John-Nagle/ttyloopdriver/case/README.md

# Ttyloopdriver case
Case for the device

## Parts

- Hammond Manufacturing 1455J1201BK. Mouser Part #: 546-1455J1201BK

- 1/8" black acrylic or acetyl sheet suitable for laser cutting

- 6-32 screws, 1/2", steel, hex or pan head, 8ea.

## End panel cutouts

The CorelDraw file is for laser cutting the end panels from plastic
sheet. CorelDraw is used because TechShop's laser cutters use it.
The file is also available as .png and .svg.
