John-Nagle/ttyloopdriver/board/images/boardpopulatedv1.0.jpg

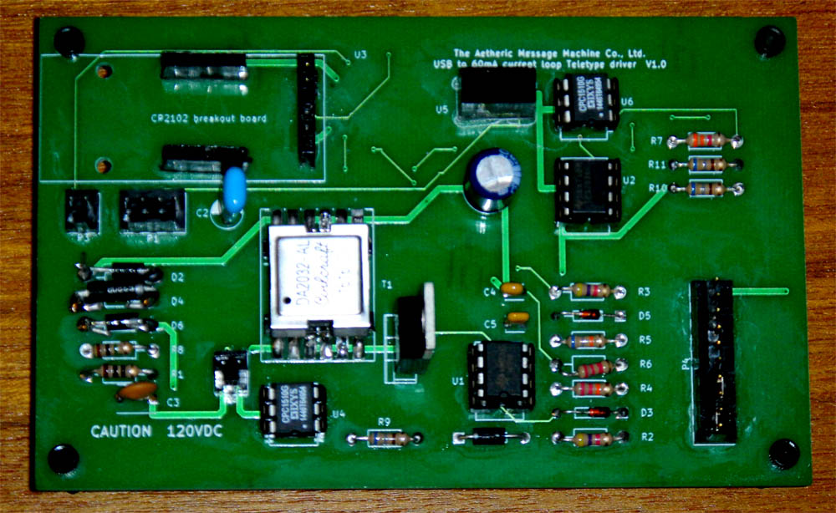
board/images/boardpopulatedv1.0.jpg
