John-Nagle/ttyloopdriver/board/images/schematic.png

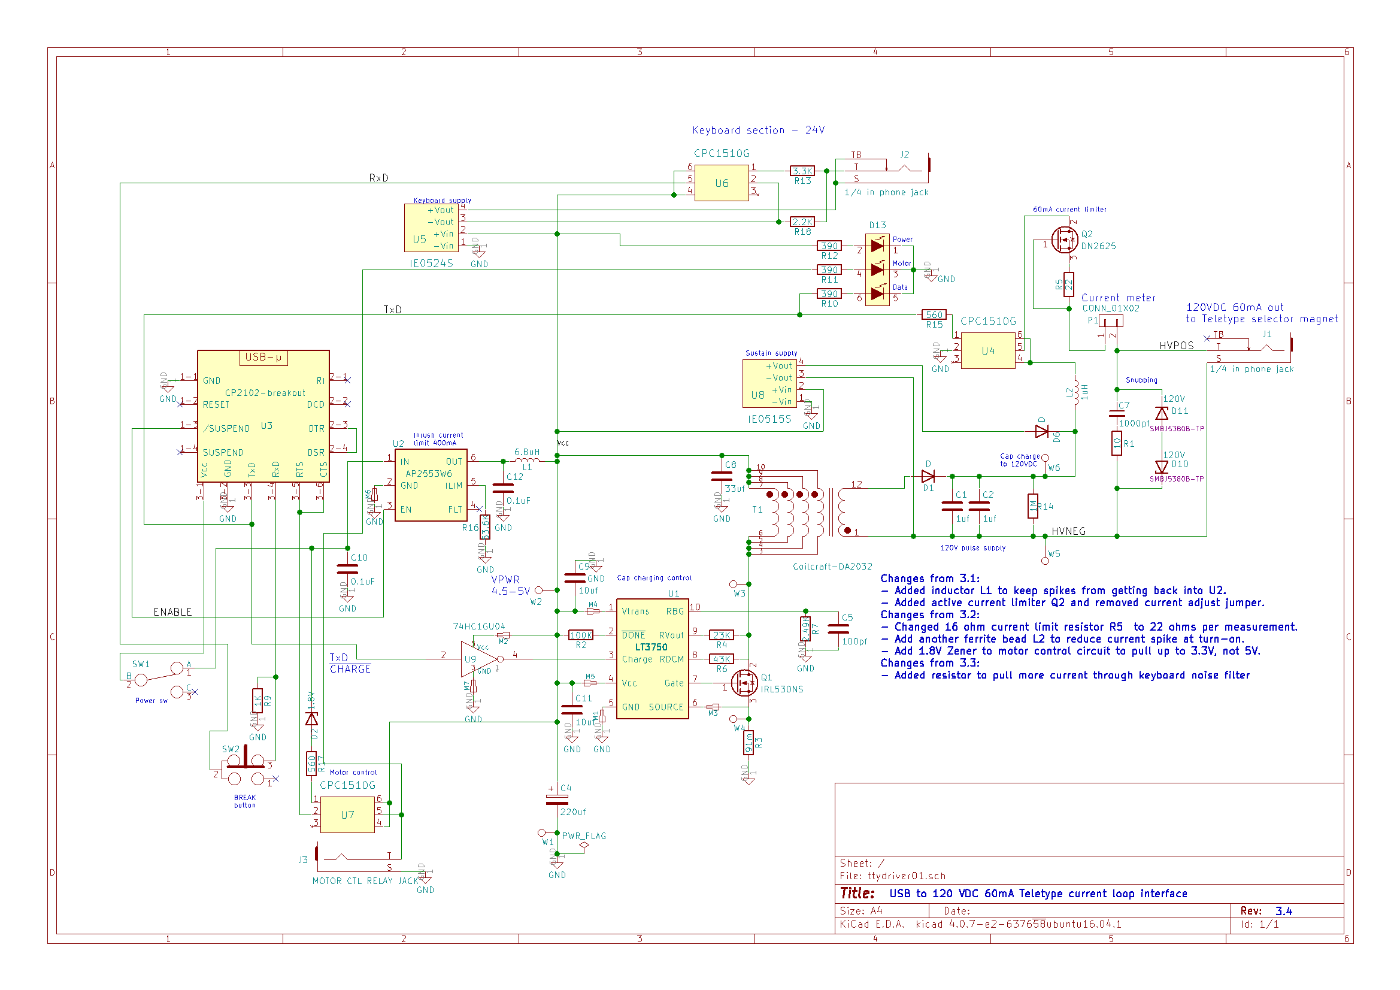
board/images/schematic.png
