John-Nagle/ttyloopdriver/parts/auxparts.ods

Auxiliary parts not in schematic BOMs
Description | Mfgr | Part | Vendor | Vendorpart | Quan | Datasheet
Enclosure | Hammond | 1455K1202 | Digikey | HM973-ND | 1 | http://www.hammondmfg.com/pdf/1455K1202.pdf
DIP socket 8 pin | Assman | A 08-LC-TT | Digikey | AE9986-ND | 2
DIP socket 6 pin | Assman | A 06-LC-TT | Digikey | AE1485-ND | 2
Silver solder | MG Chem | 4900-35G | Digikey | 473-1116-ND | 1
Desoldering tool | Aven | 17537 | Digikey | 243-1184-ND | 1 | http://media.digikey.com/pdf/Data%20Sheets/Aven%20PDFs/17537.pdf
Capacitor 1uf ceramic | Murata | RDER72E105MUB1H03B | Digikey | 490-8911-ND | 0 | http://www.murata.com/~/media/webrenewal/support/library/catalog/products/capacitor/mlcc/c49e.ashx
LED red | Broadcom | HLMP-3301-F00DD | Digikey | 516-3178-3-ND | 1 | http://www.avagotech.com/docs/AV02-1558EN
LED green | Broadcom | HLMP-3519-F0002 | Digikey | 516-3137-2-ND | 1 | http://www.avagotech.com/docs/AV02-1558EN
