John-Nagle/ttyloopdriver/(threads)

Thread 1 (2016-11-15):

Flaws in v1.0 board layout

John-Nagle, 2016-11-15:
- Q1 is backwards. This is from an error in the custom footprint. The leads are named Gate, Source, and Drain on the data sheet, rather than having pin numbers.

- Holes for D2, D4, and D6 are too small for the component leads.

- Holes for the mounting screws of U3 are too small.

- Lead spacing for C2 is too small since C2 was changed from an electrolytic to a ceramic.

John-Nagle, 2016-12-20:
Complete redesign underway

John-Nagle, 2017-04-12:
Fixed in 2.0

Closed 2017-04-12.

Thread 2 (2016-11-15):

Oscillator frequency is off

John-Nagle, 2016-11-15:
The as-built oscillator for the switcher is running at 80KHz, instead of the designed 100KHz. Also, the duty cycle seems to be higher than the designed 25%.

John-Nagle, 2016-12-20:
Complete redesign underway.

John-Nagle, 2017-04-12:
On 2.0 board, now at 85KHz, 50% duty cycle. Switcher seems to work OK, though.

John-Nagle, 2017-10-26:
Fixed in 3.x boards, which eliminate the 555 timer and use a LT3750. Switcher frequency now around 300KHz.

Closed 2017-10-26.

Thread 3 (2017-04-12):

Flaws in V2.0 board layout.

John-Nagle, 2017-04-12:
Needed changes:

- Change all test points to use header-type pins [DONE]

- R16 was ordered as 53.6 ohms, not Kohms. [DONE]

- Move R16 closer to U2. [DONE]

- Need to invert motor-on signal - RTS is a pulldown. [DONE]

- D12 causing too much voltage drop for sustain - redesign LED drive [DONE]

- TxD, RxD, RTS are 3.3V, not 5V; adjust resistor values R15. [DONE]

- Add RTS resistor [DONE]

- C2 - Use 1uF leaded ceramic.  The new multilayer SMT ceramics have very strange properties; the capacitance decreases as the voltage increases. Avoid until technology improves.

- Output side of U6 may be wired backwards. [DONE]

- Need pulldown on RxD. [DONE]

John-Nagle, 2017-04-12:
Fixed in 2.1.

Closed 2017-04-12.

Thread 4 (2017-04-27):

1uf doesn't provide enough energy to pull in the selector magnet

John-Nagle, 2017-04-27:
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

Here's a scope trace of voltage and current going into the selector magnet.  Voltage is inverted.

V is going up to about 110V.  So the cap is being fully charged.  The cap discharges in 2.5ms, and then
the sustain supply takes over.

I ramps up to about 50mA in 1ms, which is fine. But then it drops all the way down to 25mA as the cap discharges into the magnet, then goes back up as the sustain supply takes over. So 1uF isn't enough to fully charge the selector magnet. The board is functioning as intended, but just doesn't deliver enough current for long enough. The board will run one Model 15 with the selector wired for 220 ohms, but won't pull in the magnet fast enough on two different Model 14 machines, one wired for 220 ohms and the other wired for 55 ohms.

What is the actual inductance of a Teletype model 14/15 selector magnet, and what's the source for
that?  This works in SPICE assuming a 55 ohm 4H selector magnet.  I just tried a simulation with a 220 ohm 16H selector magnet, and that doesn't show the drop in current seen here.

John-Nagle, 2017-10-26:
Fixed in 3.x boards, which have 2uf and a different charging system.

Closed 2017-10-26.

Thread 5 (2018-03-09):

Keyboard input does not work with Teletype Model 15 with 92222 Filter

John-Nagle, 2018-03-09:
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

Keyboard input drops bits when the keyboard used is a Teletype Model 15 with the 92222 Filter. This is an RF noise filter present on some Teletype machines. The board design provides 24VDC for the keyboard but only draws 5mA  through the keyboard contacts. That may not be enough with the filter's added capacitance. The board may need a resistor to add some extra load.

John-Nagle, 2018-03-09:
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
This is the filter unit. It's attached above the keyboard contact cam unit.

Thread 6 (2018-06-21):

Motor Control logic is inverted from what is described

cclaunch, 2018-06-21:
The Motor Control solid state relay activates when RTS/CTS goes to low, triggering the Motor LED and sending 5V out the jack. This is the opposite of what is intended, to have the motor switch on when RTS/CTS goes high.

Closed 2018-06-26.

Thread 7 (2018-06-21):

Documentation flaw

cclaunch, 2018-06-21:
In addition to the inverted behavior of Motor control, the documentation states that the top LED indicates Power (in the section POWER MANAGEMENT) then correctly states that it is the bottom LED in the INITIAL TESTING section.

John-Nagle, 2018-07-02:
Good point on LEDs

John-Nagle, 2018-07-02:
README.md file fixed.

Closed 2018-07-02.

Thread 9 (2022-02-12):

Substitute for Q2 Needed (Impossible to buy)

va3ngc, 2022-02-12:
Is there a suitable substitute for Q2 (DN2625K4-G) as these seem to be backordered for at least a year at Digi-Key and Mouser and there are none available currently on eBay either?

va3ngc, 2022-12-01:
Was able to find Q2 from UK via Newark.  Issue has been resolved.

John-Nagle, 2022-12-07:
I'm glad you found one.

Q2 is for a two-component current regulator with significant power dissipation capability. It limits the output loop current to 60mA, even for a dead short. Unfortunately, depletion-mode FETs are somewhat exotic parts, because few people do current loops today.

Closed 2022-12-01.
