John-Nagle/ttyloopdriver/circuitsim/capcharger.asc

A1: inv; Vhigh=3.3
C1: cap; 1µf; Rser=0.1
C2: cap; 1µf; Rser=0.1
C4: cap; 220µf
C5: cap; 100p
C6: cap; 0.1µf; Rser=0.1
C7: cap; 1000pf
C8: cap; 33µf; Rser=0.1
D1: diode
D6: diode; MURS120
D10: zener; 1N5380BG
D11: zener; 1N5380BG
L1: ind; 6.8µ; Ipk=1A Rser=0.312 Cpar=0
L2: ind; 1µ; Ipk=2.3A Rser=0.090 Cpar=0
L3: ind2; 10µ; Cpar=200p
L4: ind2; 1m
L5: ind; 5.5H; Rser=220
M1: nmos; DN2535
Q1: nmos; IRL530NS_L
R1: res; 10
R2: res; 100K
R3: res; 91m
R4: res; 23K
R5: res; 22
R6: res; 43K
R7: res; 2.49K
S1: sw; SW1
U1: LT3750
V1: voltage; 4.8; Rser=0.1
V2: voltage; 15V; Rser=1
V3: voltage; PULSE(0 3.3 0 1us 1us 22ms 44ms)
Named nets: 0, Vcap, Vsel, Charge, ser, Vcc
.tran 0 100ms 0
ESR 0.1 ohm
.model 1N5380BG D(bv=120v ibv=1ma mfg=OnSemi type=Zener)
.model SW1 SW(Ron=1.7 Roff=10Meg Vt=1.1 Vh=0.1)
Selector magnet
Sustain supply
(XP Power IE0515S)
Serial data source
CPC1510G opto
Snubbing
K1 L3 L4 1
Notes:
- Based on Linear Technology sample circuit for LT3750.
- Recommended transformer and MOSFET per LT example.
- Input current limit is set with R3. I = 78mV/R2
- Max voltage of charge is set with R4.
- Charges 2uf cap to 120V.
- Should provide 60mA into 5.5H selector
Teletype loop driver using LT3750  Capacitor Charger Controller
Input: 4.8V   Output: 120V
Coilcraft DA2032-AL
.lib dn2535.lib
60mA current limiter
Model for M1 should be DN2625, not DN2535. They're close but not identical.
