John-Nagle/ttyloopdriver/circuitsim/ttydriver.asc

C1: cap; 22µf; Rser=0.1
C2: cap; 1µf; Rser=0.1
C3: cap; 10pf
C4: cap; 1000pf; Rser=0.1
C5: cap; 22µf; Rser=0.1
C6: cap; 10nf
C7: cap; 1000pf
C8: cap; 910pf
C9: polcap; 470µf; Rser=2
C11: cap; 1µf; Rser=0.1
C13: cap; 22µf; Rser=0.1
C14: polcap; 470µf; Rser=2
D1: diode; MURS120
D6: diode; MURS120
D7: zener; 1N5380BG
D9: schottky; RSX071VA-30
D10: zener; 1N5380BG
D11: zener; 1N5380BG
L1: ind2; 19µH; Rser=0.036
L2: ind2; 4864µH; Rser=16.5
L3: ind; 10µ; Ipk=0.27 Rser=1.2986 Rpar=942 Cpar=0 mfg="Coilcraft" pn="0805PS-103"
L4: ind; 5.5H; Rser=220
M1: nmos; FDS4559_N
R1: res; 10
R2: res; 2.2
R3: res; 22
R4: res; 10K
R5: res; 150
R6: res; 715
R7: res; 7.15K
R8: res; 2.2K
R18: res; 2.2
S1: sw; SW1
U1: NE555
V1: voltage; 4.8; Rser=0.3
V2: voltage; 12V; Rser=1
V3: voltage; PULSE(0 3.3 24ms 1us 1us 22ms 44ms)
Named nets: 0, Vcap, Vsel, Vgate, Vcc
.tran 0 75ms 2ms 100n uic
.options Gmin=1e-9  method=Gear
K1 L1 L2 0.95
Coilcraft FA2469-AL
ESR 0.1 ohm
60V, 4.5A MOSFET
SMT package contains two, one N-type and 1 P-type
Only using N-type
ESR 0.1 ohm
ESR 0.1 ohm
.model 1N5380BG D(bv=120v ibv=1ma mfg=OnSemi type=Zener)
120V Zener
ESR 0.1 ohm
Coilcraft 0805PS-103
.model SW1 SW(Ron=1 Roff=10Meg Vt=1.1 Vh=0.1)
Selector magnet
Sustain supply
(XP Power IE0512S)
Serial data source
Osc inhibit
CPC1510G opto
Snubbing
Oscillator 100KHz 50% duty cycle
Jumper for 220
ohm selector
2uf cap, different power supply filtering
Should provide 60mA into 5.5H selector
