John-Nagle/ttyloopdriver/(list of files, drawings)

Other design files:
board/ttydriver01.dsn
