John-Nagle/ttyloopdriver/board/ttydriver01.kicad_pcb

## KiCad design board/ttydriver01.kicad_pcb (2018-05-02)

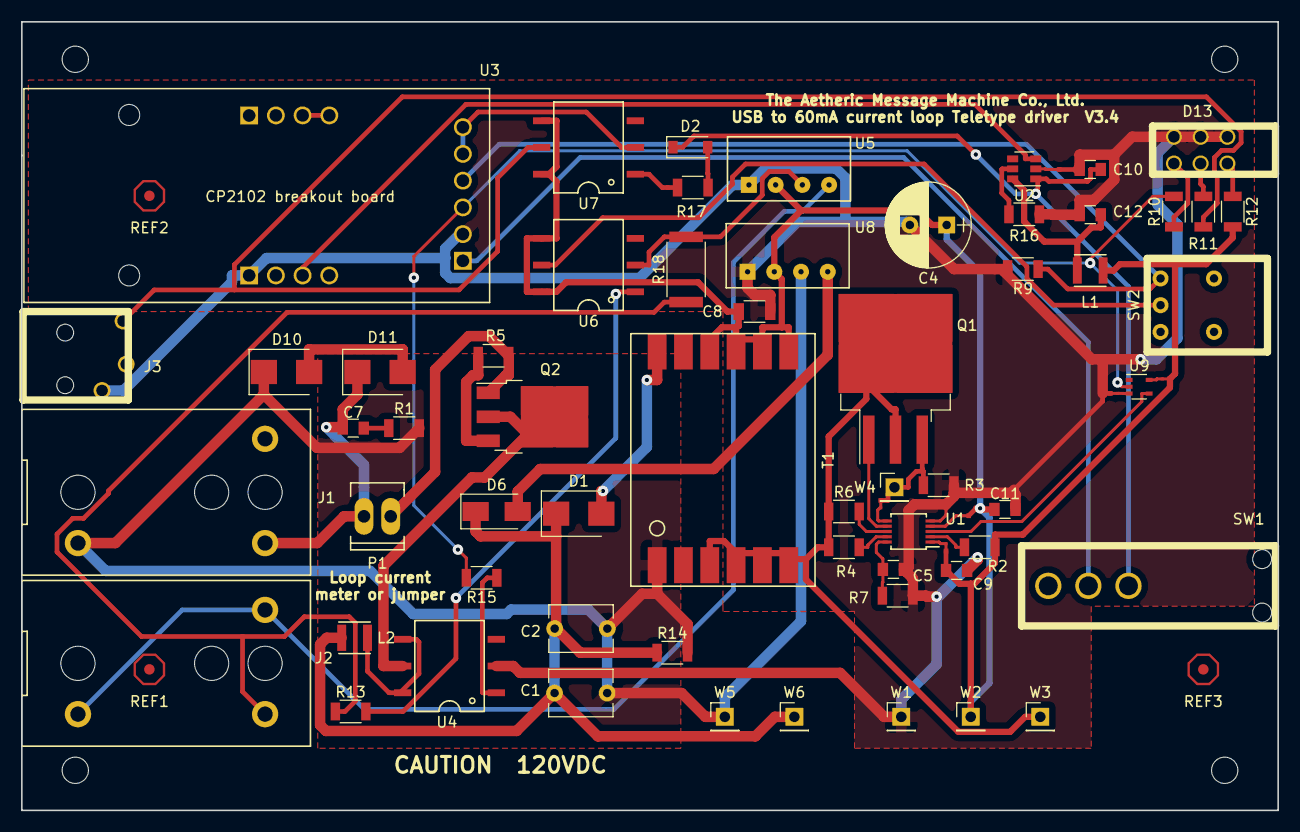
[picture p4: board ttydriver01.kicad_pcb from above]

Board: 2 copper layers, 119.4 x 74.9 mm, 73 parts (0 on the bottom side), 49 nets.

Parts:
C1, C2: 1uf; C_Disc_D6.0mm_W4.4mm_P5.00mm
C4: 220uf; CP_Radial_D8.0mm_P3.50mm
C5: 100pf; C_0805
C7: 1000pf; C_0805
C8: 33uf; C_1206
C9, C11: 10uf; C_0805
C10, C12: 0.1uF; C_0805
D1: D; D_SMB
D2: 1.8V; D_SOD-123
D6: D; SMA_Standard
D10, D11: 120V; SMB_Standard
D13: LED_3; 564-0100
H1, H2, H3, H4: MountingHole_2.5mm
J1, J2: 1/4 in phone jack; Switchcraft-SN37A12A
J3: MOTOR CTL RELAY JACK; MJ-2509N
L1: 6.8uH; Samsung-Inductor-1008
L2: 1uH; Samsung-Inductor-1008
M1, M2, M3, M4, M5, M6, M7: narrower_0.3mm; trace_narrower_0.3mm
P1: CONN_01X02; Socket_MOLEX-KK-RM2-54mm_Lock_2pin_straight
Q1: IRL530NS; TO-263-3_TabPin2
Q2: DN2625; TO-252-3_TabPin2
R1: 10; R_1206
R2: 100K; R_1206
R3: 91m; R_1206
R4: 23K; R_1206
R5: 22; R_1206
R6: 43K; R_1206
R7: 2.49K; R_1206
R9: 1K; R_1206
R10, R11, R12: 390; R_1206
R13: 3.3K; R_1206
R14: 1M; R_1206
R15, R17: 560; R_1206
R16: 53.6K; R_1206
R18: 2.2K; R_2512
REF1, REF2, REF3: Fiducial_Image_Seeed; Fiducial_Image_Seeed_Top
SW1: Switch_SPDT; Toggle-M2012SA2W40
SW2: Button_SPDT; BB15AH-FA
T1: Coilcraft-DA2032; Coilcraft-DA2032-AL
U1: LT3750
U2: AP2553W6; SOT-23-6
U3: CP2102-breakout
U4, U6, U7: CPC1510G; DIP-6_SMD
U5: IE0524S
U8: IE0515S; IE0524S
U9: 74HC1GU04; SOT-353_SC-70-5
W1, W2, W3, W4, W5, W6: TEST_1P; Pin_Header_Straight_1x01_Pitch2.54mm

Connections:
/ENABLE: U2.3, U3.1-3
/HVNEG: C1.2, C2.2, D10.1, J1.S, R1.2, R14.2, T1.1, U8.3, W5.1
/HVPOS: C7.1, D11.1, J1.T, P1.2
/RxD: SW2.2, U6.5
/TxD: R10.2, R15.2, U3.3-3, U9.2
/Vcc: C4.1, C8.1, C9.2, C11.1, L1.2, M2.1, M4.1, M5.1, R2.2, R12.2, T1.7, T1.8, T1.9, T1.10, U5.2, U6.4, U6.6, U7.4, U7.6, U8.2, W2.1
GND: C4.2, C5.2, C8.2, C9.1, C10.2, C11.2, C12.2, D13.1, D13.3, D13.5, J3.S, M1.1, M6.1, M7.1, R3.2, R7.2, R9.2, R16.2, U3.1-1, U3.3-2, U4.2, U5.1, U8.1, W1.1
unnamed: C1.1, C2.1, D1.1, D6.1, L2.2, R14.1, W6.1
unnamed: C5.1, R7.1, U1.10
unnamed: C7.2, R1.1
unnamed: C10.1, D2.1, SW1.1, U2.1
unnamed: C12.1, L1.1, U2.6
unnamed: D1.2, T1.12
unnamed: D2.2, R17.1
unnamed: D6.2, U8.4
unnamed: D10.2, D11.2
unnamed: D13.2, R12.1
unnamed: D13.4, R11.1
unnamed: D13.6, R10.1
unnamed: J2.S, J2.TB, U5.4
unnamed: J2.T, R13.1, R18.1
unnamed: J3.T, R11.2, U7.5
unnamed: L2.1, U4.4, U4.6
unnamed: M1.2, U1.5
unnamed: M2.2, U9.5
unnamed: M3.1, Q1.3, R3.1, W4.1
unnamed: M3.2, U1.6
unnamed: M4.2, U1.1
unnamed: M5.2, U1.4
unnamed: M6.2, U2.2
unnamed: M7.2, U9.3
unnamed: P1.1, Q2.1, R5.1
unnamed: Q1.1, U1.7
unnamed: Q1.2, R4.1, R6.1, T1.3, T1.4, T1.5, T1.6, W3.1
unnamed: Q2.2, U4.5
unnamed: Q2.3, R5.2
unnamed: R2.1, U1.2
unnamed: R4.2, U1.9
unnamed: R6.2, U1.8
unnamed: R9.1, SW2.3, U3.3-4
unnamed: R13.2, U6.1
unnamed: R15.1, U4.1
unnamed: R16.1, U2.5
unnamed: R17.2, U7.1
unnamed: R18.2, U5.3, U6.2
unnamed: SW1.2, U3.3-1
unnamed: U1.3, U9.4
unnamed: U3.2-3, U3.2-4
unnamed: U3.3-5, U3.3-6, U7.2
