John-Nagle/ttyloopdriver/(commit log)

2016-10-12 Moving footprints to project
2016-10-12 Add 24VDC supply for keyboard
    [ttydriver01.kicad_pcb, ttydriver01.sch]
2016-10-12 Update README and part number of zener diode
    [ttydriver01.sch]
2016-10-12 Added footprint for DC-DC converter
    [ttydriver01.kicad_pcb]
2016-10-12 Moved 3D shapes to .3dshapes file per KiCAD standards
    [ttydriver01.kicad_pcb]
2016-10-15 revise front panel connections. Schematic is about done.
    [ttydriver01.kicad_pcb, ttydriver01.sch]
2016-10-16 Improve board layout. Get HV stuff into clear area.
    [ttydriver01.kicad_pcb]
2016-10-16 Everything placed. Ready to start adding tracks
    [ttydriver01.kicad_pcb]
2016-10-16 Connectivity on board doesn't match connectivity on schematic
    [ttydriver01.kicad_pcb]
2016-10-16 Relabled some nets - fixed connectivity
    [ttydriver01.kicad_pcb, ttydriver01.sch]
2016-10-16 Add GND fill area. Still no tracks
    [ttydriver01.kicad_pcb]
2016-10-16 New smaller pads for connectors. HV part laid out.
    [ttydriver01.kicad_pcb]
2016-10-17 All traces in place; now to begin cleanup
    [ttydriver01.kicad_pcb, ttydriver01.sch]
2016-10-17 Passes DRC. Valid board. Still needs more cleanup.
    [ttydriver01.kicad_pcb]
2016-10-17 Cleaned up copper fill. Almost ready for fab.
    [ttydriver01.kicad_pcb]
2016-10-17 Adding part number information
    [ttydriver01.sch]
2016-10-17 Added all part info except resistors and small caps.
    [ttydriver01.sch]
2016-10-18 Working on turning BOM into a usable form for DigiKey
2016-10-18 More progress on BOM converter
2016-10-18 Beginning to generate a BOM on DigiKey. Not all parts listed yet.
    [ttydriver01.sch]
2016-10-18 Working on BOM - info valid, but some parts unavailable
    [ttydriver01.sch]
2016-10-18 BOM program now produces multiple .CSV files
    [ttydriver01.sch]
2016-10-18 Updating BOM to something buyable
    [ttydriver01.sch]
2016-10-18 All caps added. Just resistors left to add to BOM
    [ttydriver01.kicad_pcb, ttydriver01.sch]
2016-10-18 All parts assigned a vendor
    [ttydriver01.sch]
2016-10-18 Change resistor R12 to unused R8
    [ttydriver01.kicad_pcb]
2016-10-18 Closed board
    [ttydriver01.kicad_pcb]
2016-10-19 Ready for fab
    [ttydriver01.kicad_pcb]
2016-10-19 Files ready for fab of board V1.0
    [ttydriver01-B.Cu.gbr, ttydriver01-Edge.Cuts.gbr, ttydriver01-F.Cu.gbr, ttydriver01-F.SilkS.gbr, ttydriver01-NPTH.drl, ttydriver01.drl]
2016-10-19 Board ordered from SEEED
    [ttydriver01.kicad_pcb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]
2016-10-19 Added front and back mask files
    [ttydriver01-B.Cu.gbr, ttydriver01-B.Mask.gbr, ttydriver01-Edge.Cuts.gbr, ttydriver01-F.Cu.gbr, ttydriver01-F.Mask.gbr, ttydriver01-F.SilkS.gbr, ttydriver01-NPTH.drl, ttydriver01.drl]
2016-10-19 Add cable harness drawing. No parts list for it yet
    [ttydriver01-B.Cu.gbr, ttydriver01-B.Mask.gbr, ttydriver01-Edge.Cuts.gbr, ttydriver01-F.Cu.gbr, ttydriver01-F.Mask.gbr, ttydriver01-F.SilkS.gbr, ttydriver01-NPTH.drl, ttydriver01.drl]
2016-10-22 Still adding parts. Need to add indicators and switches
    [auxparts.ods, ttyloopdrivercables01.sch]
2016-10-24 Parts list as ordered
    [auxparts.ods, ttydriver01.sch, ttyloopdrivercables01.sch]
2016-10-25 Fix schematic symbols not in board library
    [ttydriver01.kicad_pcb, ttydriver01.sch]
2016-10-25 Minor cleanup
    [ttydriver01.sch]
2016-10-26 Update 3D models to get a good board image
    [ttydriver01.kicad_pcb]
2016-11-15 As-built board image
2016-12-06 Doesnt't work. Tell users
    [ttydriver01.sch]
2016-12-17 Adding Switchcraft jacks
2016-12-18 Pads and 3D models for Coilcraft and Switchcraft parts
2016-12-20 Adding 3D models for Coilcraft, Switchcraft, Dialite, and NKK parts
2016-12-26 Add LED and jumper for 220 ohm selector magnet
2016-12-30 Add LED, simplify full wave bridge, change OSC INHIBIT resistor
2017-01-02 Revising schematic for V2. Not done.
    [ttydriver01.sch]
2017-01-02 Revising schematic for V2. Some DRC errors.
    [ttydriver01.sch]
2017-01-02 Close to final design, pending tests
    [ttydriver01.sch]
2017-01-04 Basic schematic complete; BOM info and footprints not ready
    [ttydriver01.sch]
2017-01-05 Working on adding footprints
    [ttydriver01.sch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]
2017-01-06 More adding of footprints
    [ttydriver01.sch]
2017-01-06 Footprints filled in; initial schematic complete except for all BOM info
    [ttydriver01.sch]
2017-01-07 Beginning board layout
    [ttydriver01.kicad_pcb, ttydriver01.sch]
2017-01-07 Minor board update
    [ttydriver01.kicad_pcb]
2017-01-08 Initial go at placement on board
    [ttydriver01.kicad_pcb, ttydriver01.sch]
2017-01-08 Fix minor placement problems
    [ttydriver01.kicad_pcb]
2017-02-06 Fabbable board, but BOM not entirely filled in
    [ttydriver01-B.Cu.gbr, ttydriver01-B.Mask.gbr, ttydriver01-Edge.Cuts.gbr, ttydriver01-F.Cu.gbr, ttydriver01-F.Mask.gbr, ttydriver01-F.SilkS.gbr, ttydriver01-NPTH.drl, ttydriver01.drl]
2017-02-07 Move components slightly to improve layout
    [ttydriver01.dsn, ttydriver01.kicad_pcb]
2017-02-07 Generate fab files. Awaiting proto test before fabbing
    [ttydriver01-B.Cu.gbr, ttydriver01-B.Mask.gbr, ttydriver01-Edge.Cuts.gbr, ttydriver01-F.Cu.gbr, ttydriver01-F.Mask.gbr, ttydriver01-F.SilkS.gbr, ttydriver01-NPTH.drl, ttydriver01.drl]
2017-02-07 Untested but fabbable board
    [ttydriver01-B.Cu.gbr, ttydriver01-B.Mask.gbr, ttydriver01-Edge.Cuts.gbr, ttydriver01-F.Cu.gbr, ttydriver01-F.Mask.gbr, ttydriver01-F.SilkS.gbr, ttydriver01-NPTH.drl, ttydriver01.drl]
2017-02-07 Add image of board
2017-03-02 PC board generated good BOM for DigiKey
    [ttydriver01.sch]
2017-03-03 Fixed resistor and cap part numbers. Not done.
    [ttydriver01.sch]
2017-03-03 Fixed resistor and cap part numbers. As ordered
    [ttydriver01.sch]
2017-03-04 Trying to fix problem with schematic symbol
    [ttydriver01.sch]
2017-03-11 KiCAD changed names of diode 3D models. Fix accordingly.
    [ttydriver01.kicad_pcb]
2017-03-11 All 3D model links changed to new parts.
    [ttydriver01.kicad_pcb]
2017-03-29 Note some problems on schematic
2017-04-05 Last changes to 2.0 board notes
    [ttydriver01.sch]
2017-04-10 Close to working, but some component values may change. Not all part numbers for resistors and caps set.
    [ttydriver01.sch]
2017-04-10 Ready for trying autorouting.
    [ttydriver01.sch]
2017-04-10 First try at 2.1 autorouting
    [ttydriver01.dsn, ttydriver01.kicad_pcb]
2017-04-11 Successful autoroute. Board lacks mounting holes
    [ttydriver01.dsn, ttydriver01.kicad_pcb, ttydriver01.sch]
2017-04-11 Successful autoroute. Mounting holes added. Check further before fab.
    [ttydriver01.dsn, ttydriver01.kicad_pcb]
2017-04-11 BOM data updated. Next, final check before fab
    [ttydriver01.dsn, ttydriver01.kicad_pcb, ttydriver01.sch]
2017-04-11 Generated fab files
    [ttydriver01-B.Cu.gbr, ttydriver01-B.Mask.gbr, ttydriver01-Edge.Cuts.gbr, ttydriver01-F.Cu.gbr, ttydriver01-F.Mask.gbr, ttydriver01-F.SilkS.gbr, ttydriver01-NPTH.drl, ttydriver01.drl]
2017-04-11 Generated fab files with bigger via rings to pass DRC
    [ttydriver01-B.Cu.gbr, ttydriver01-B.Mask.gbr, ttydriver01-Edge.Cuts.gbr, ttydriver01-F.Cu.gbr, ttydriver01-F.Mask.gbr, ttydriver01-F.SilkS.gbr, ttydriver01-NPTH.drl, ttydriver01.drl]
2017-04-20 2.1 as built
    [ttydriver01.dsn]
2017-04-23 Add notes on results with board 2.1
2017-04-23 V2.2 board fixes in
    [ttydriver01.sch]
2017-04-23 V2.2 board fixes on PCB
    [ttydriver01.dsn, ttydriver01.kicad_pcb]
2017-04-24 Reeady to go to fab
    [ttydriver01-B.Cu.gbr, ttydriver01-B.Mask.gbr, ttydriver01-Edge.Cuts.gbr, ttydriver01-F.Cu.gbr, ttydriver01-F.Mask.gbr, ttydriver01-F.SilkS.gbr, ttydriver01-NPTH.drl, ttydriver01.drl]
2017-05-13 New circuit simulation with 2uf cap. Appears to work in sim.
2017-05-13 Rework for 2uf cap design. Sim works
    [ttydriver01.sch]
2017-05-13 Mods for v2.3 complete - ready to try layout
    [ttydriver01.sch]
2017-05-13 Successful routing - needs final check
    [ttydriver01.dsn, ttydriver01.kicad_pcb]
2017-05-13 Moved some parts to reduce trace length
    [ttydriver01.dsn, ttydriver01.kicad_pcb]
2017-05-13 Update documentation
    [ttydriver01.sch]
2017-05-14 Add fidicuial marks
    [ttydriver01.dsn, ttydriver01.kicad_pcb]
2017-05-14 Add bottom fidicuial footprint
2017-05-14 Use modified fiducial with exposed copper octagon
    [ttydriver01.kicad_pcb]
2017-05-15 Ready to go to fab
    [ttydriver01.dsn, ttydriver01.kicad_pcb]
2017-05-15 Fab files generated
    [ttydriver01-B.Cu.gbr, ttydriver01-B.Mask.gbr, ttydriver01-Edge.Cuts.gbr, ttydriver01-F.Cu.gbr, ttydriver01-F.Mask.gbr, ttydriver01-F.SilkS.gbr, ttydriver01-NPTH.drl, ttydriver01.drl]
2017-06-27 Final 2.x version, as built, doesn't output enough power
2017-06-27 Version 3, first draft
    [ttydriver01.sch]
2017-06-27 Complete, but needs a real part for inverter U9
    [ttydriver01.sch]
2017-06-27 Passes DRC, some footprint problems
    [ttydriver01.sch]
2017-06-28 Beginnings of layout. All components present
    [ttydriver01.kicad_pcb, ttydriver01.sch]
2017-06-28 Add capcharger sim
    [ttydriver01.kicad_pcb]
2017-06-28 Working on trace widths
    [ttydriver01.kicad_pcb]
2017-06-29 Board passes DRC; Schematic still has an error
2017-06-29 Board passes DRC; corners clipped on layout
    [ttydriver01.dsn, ttydriver01.kicad_pcb, ttydriver01.sch]
2017-06-29 Fix solder mask tolerance to avoid exposed copper at sharp corners
    [ttydriver01.kicad_pcb]
2017-06-30 3D models fixed
    [ttydriver01.dsn, ttydriver01.kicad_pcb]
2017-06-30 Switch optos to SMD form
    [ttydriver01.dsn, ttydriver01.kicad_pcb, ttydriver01.sch]
2017-06-30 Add new footprint for gull-wing opto
2017-07-03 Adding new footprint for DIP-6_SMD parts
    [ttydriver01.sch]
2017-07-03 Unrouted board passes DRC
    [ttydriver01.kicad_pcb]
2017-07-03 Routed, ready for manual cleanup. Needs some part numbers
    [ttydriver01.dsn, ttydriver01.kicad_pcb]
2017-07-03 Adjusted track widths
    [ttydriver01.dsn, ttydriver01.kicad_pcb, ttydriver01.sch]
2017-07-03 Close to done.
    [ttydriver01.dsn, ttydriver01.kicad_pcb, ttydriver01.sch]
2017-07-04 All 3D models and tracks OK. Just need some part numbers
    [ttydriver01.kicad_pcb, ttydriver01.sch]
2017-07-04 Ready for fab and ordering
    [ttydriver01-B.Cu.gbr, ttydriver01-B.Mask.gbr, ttydriver01-Edge.Cuts.gbr, ttydriver01-F.Cu.gbr, ttydriver01-F.Mask.gbr, ttydriver01-F.SilkS.gbr, ttydriver01-NPTH.drl, ttydriver01.drl]
2017-07-22 Begin v3.1 board.
    [ttydriver01.dsn, ttydriver01.kicad_pcb, ttydriver01.sch]
2017-07-22 Autorouting works
    [ttydriver01.kicad_pcb]
2017-07-28 KiCAD version update?
2017-08-01 Adding more bypass caps to reduce ringing
    [ttydriver01.sch]
2017-08-02 Added more bypass caps, changed D1 for faster diode
    [ttydriver01.sch]
2017-08-02 New layout with shorter paths in switcher area and a copper pour
    [ttydriver01.dsn, ttydriver01.kicad_pcb]
2017-08-02 Adjusting copper pour. Layout could use some tweaking but is close
    [ttydriver01.kicad_pcb]
2017-08-02 Update schematic
    [ttydriver01.sch]
2017-08-02 Fix D1 3D model
    [ttydriver01.kicad_pcb]
2017-08-04 Routed, but no ground plane
    [ttydriver01.dsn, ttydriver01.kicad_pcb, ttydriver01.sch]
2017-08-04 Routed better. No ground plane, but heavier ground in good place
    [ttydriver01.dsn, ttydriver01.kicad_pcb]
2017-08-04 Add copper pours
    [ttydriver01.kicad_pcb]
2017-08-04 Generate fabrication files
    [ttydriver01-B.Cu.gbr, ttydriver01-B.Mask.gbr, ttydriver01-Edge.Cuts.gbr, ttydriver01-F.Cu.gbr, ttydriver01-F.Mask.gbr, ttydriver01-F.SilkS.gbr, ttydriver01-NPTH.drl, ttydriver01.drl]
2017-08-04 As submitted for fab
    [ttydriver01.kicad_pcb]
2017-08-29 Board 3.1 as built and tested
2017-08-30 Beginning 3.2 board
    [ttydriver01.sch]
2017-08-30 First routed 3.2 board. No copper pour yet.
    [ttydriver01.dsn, ttydriver01.kicad_pcb]
2017-08-31 Trying new current limiter simulation.
2017-09-04 Add active current limiter
    [ttydriver01.sch]
2017-09-04 Add active current limiter on board. Good autoroute, no fills yet.
    [ttydriver01.dsn, ttydriver01.kicad_pcb, ttydriver01.sch]
2017-09-04 Add active current limiter on board. Good autoroute, fills, almost ready for fab
    [ttydriver01.kicad_pcb, ttydriver01.sch]
2017-09-04 As sent to fab
    [ttydriver01-B.Cu.gbr, ttydriver01-B.Mask.gbr, ttydriver01-Edge.Cuts.gbr, ttydriver01-F.Cu.gbr, ttydriver01-F.Mask.gbr, ttydriver01-F.SilkS.gbr, ttydriver01-NPTH.drl, ttydriver01.drl]
2017-09-08 Add .gitattributes because GitHub is mis-identifying KiCAD source
2017-09-08 Remove unused device sim file
2017-09-17 Board 3.2 built and tested. Notes.
2017-09-19 Update for current board
2017-09-19 Current image
2017-09-19 Fix 12V->15V
2017-09-21 Begin 3.3 board. Fix motor control to use 3.3V into relay, not 5V. Add ferrite bead. Delete unused C3
    [ttydriver01.sch]
2017-09-21 Fix comments
    [ttydriver01.sch]
2017-09-21 V3.3 board routed
    [ttydriver01.dsn, ttydriver01.kicad_pcb]
2017-09-22 Laid out board 3.3
    [ttydriver01.kicad_pcb]
2017-09-23 V3.3 board as submitted.
    [ttydriver01-B.Cu.gbr, ttydriver01-B.Mask.gbr, ttydriver01-Edge.Cuts.gbr, ttydriver01-F.Cu.gbr, ttydriver01-F.Mask.gbr, ttydriver01-F.SilkS.gbr, ttydriver01-NPTH.drl, ttydriver01.drl]
2017-09-25 Fixing 3D images on board because KiCAD libraries changed.
    [ttydriver01.kicad_pcb]
2017-10-09 Add case layout
2017-10-13 Board 3.3 as built and working
    [ttydriver01.sch]
2017-10-14 Add BOM files in .csv format
    [ttydriver01-COILCRAFT.csv, ttydriver01-DIGIKEY.csv, ttydriver01-NONE.csv, ttydriver01-ROBOTSHOP.csv]
2017-10-17 Fix part numbers for BOM to avoid duplicate entries
    [ttydriver01.sch]
2017-10-17 Regenerate BOM .csv files
    [ttydriver01-DIGIKEY.csv]
2017-12-04 Update schematic image
2018-05-02 Begin board 3.4 - adding load resistor for keyboard
    [ttydriver01.dsn, ttydriver01.kicad_pcb, ttydriver01.sch]
2018-09-10 Add schematic
